jswiles/LoRaIO_3x12T/README.md

# LoRa Terminal I/O Board

LoRa (3) 12 Screw Terminal I/O Board

- 24LC32A 4K byte EEPROM 
    - Connected to I2C bus 1, can be used  for device configuration and data logging. 

- Buffered TTL RS-232 I/O   
    - UART1 – Debug port 
    - UART2 – User port 

- LTC4311 I2C Bus Accelerator 
    - Up to 1 meter length connections to I2C bus 2 at 400Khz.

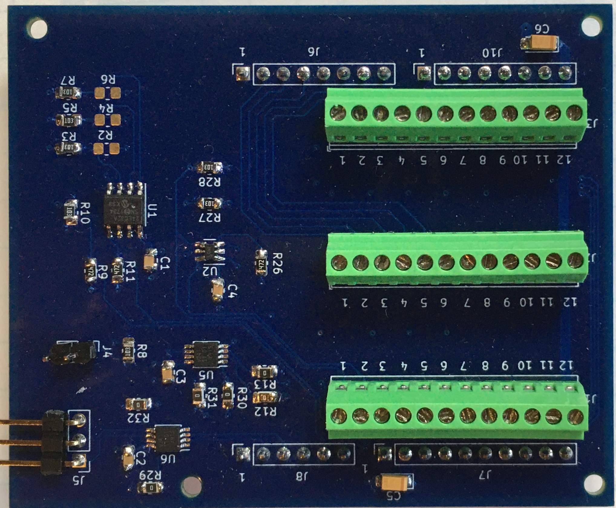
[picture p1: Photos/LoRaIO_3x12T_R1.JPG]
LoRaIO_3x12T_R1 Revision 1


Revision 1 

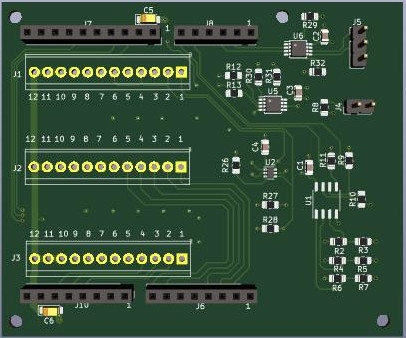
[picture p2: Photos/LoRaIO_3x12T_R13D.JPG]
LoRaIO_3x12T_R2 Revision 2


Revision 1 3D Model
