jswiles/LoRaIO_3x12T/Documents/LoRaIO_3x12T_SCH_R1.pdf

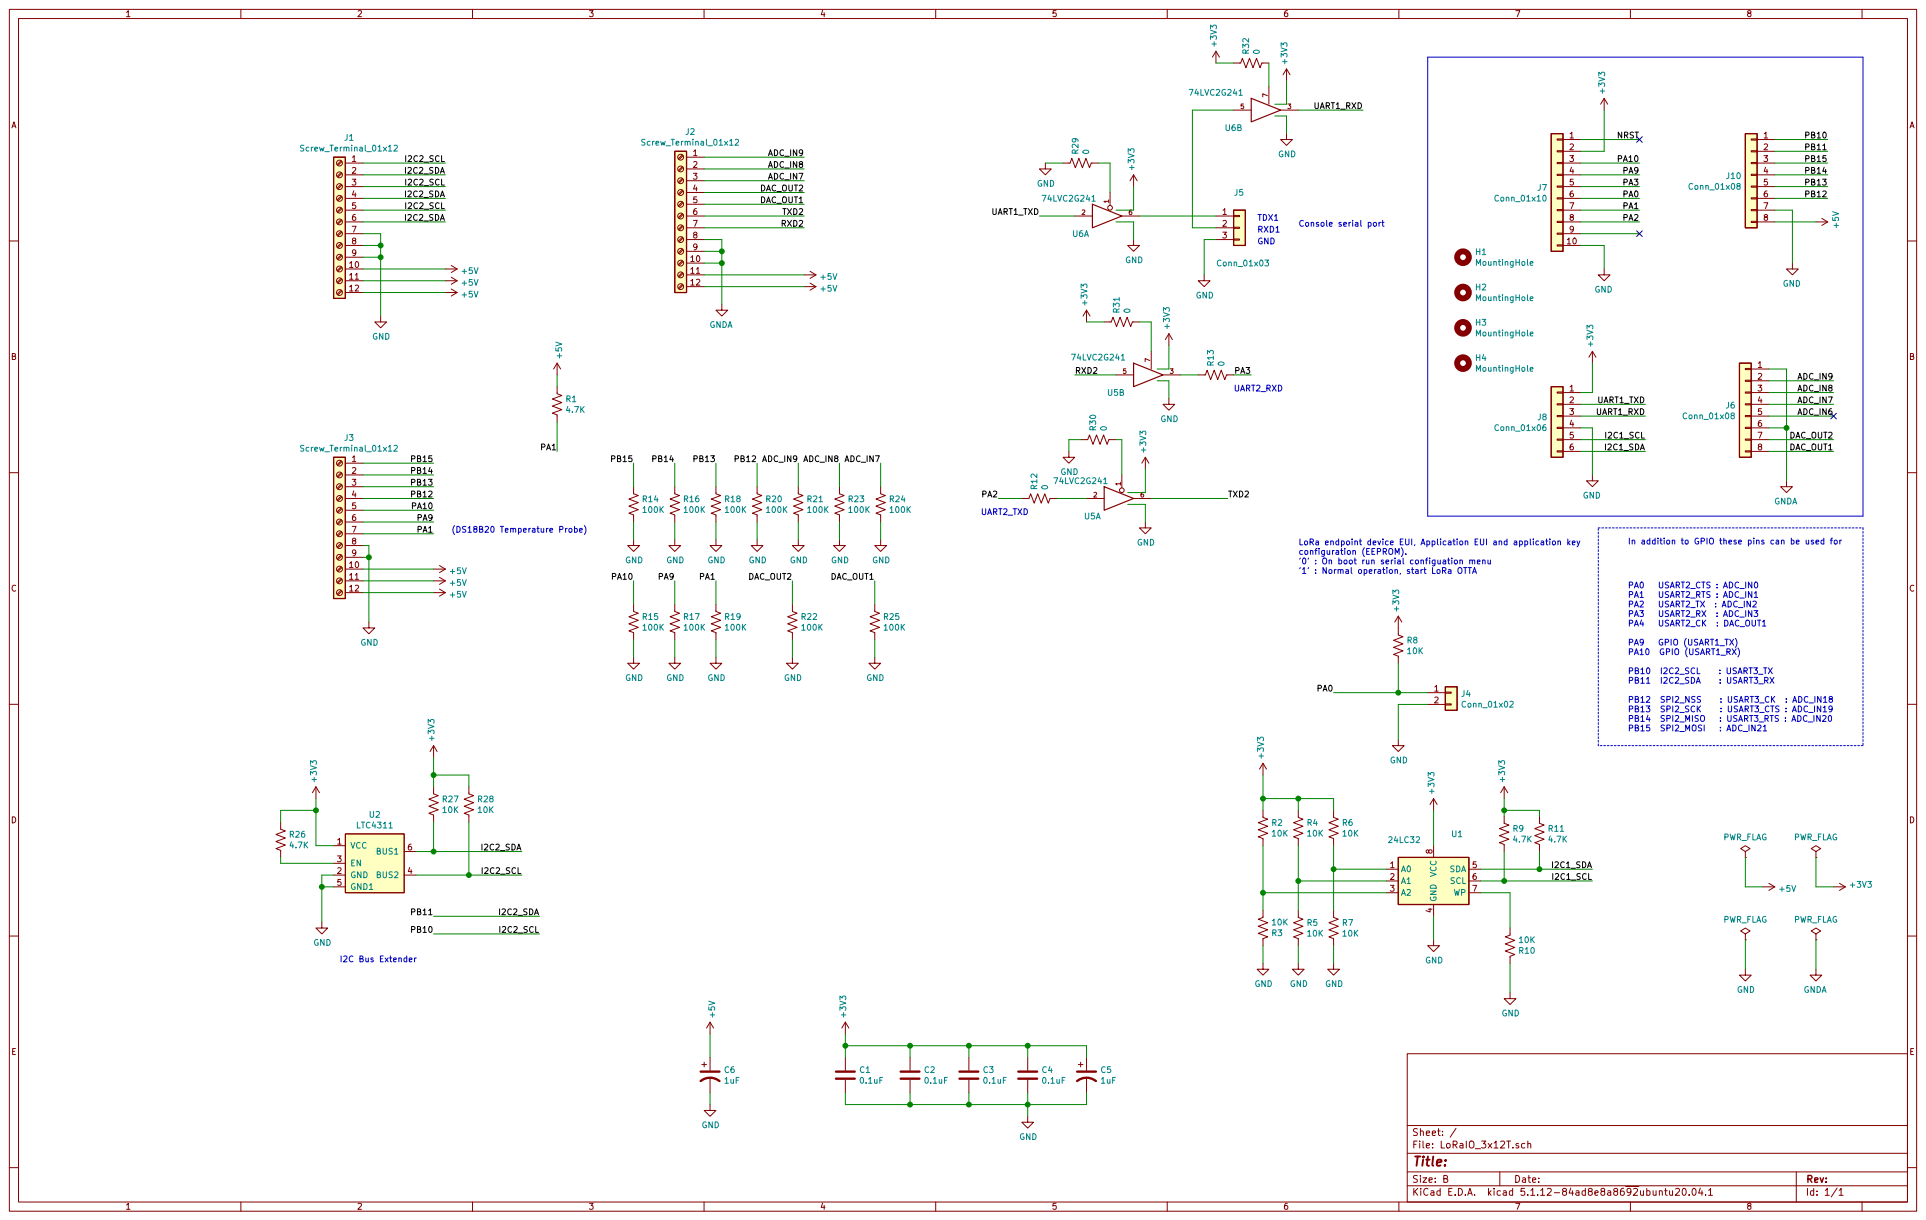
[picture p4: page 1]

In addition to GPIO these pins can be used for TDX1 UART2_RXD
RXD1
GND

'1' : Normal operation, start LoRa OTTA UART2_TXD

LoRa endpoint device EUI, Application EUI and application key
configuration (EEPROM).
'0' : On boot run serial configuation menu
