jswiles/LoRaIO_3x12T/Schematic/LoRaIO_3x12T.kicad_pcb

## KiCad design Schematic/LoRaIO_3x12T.kicad_pcb (2022-08-01)

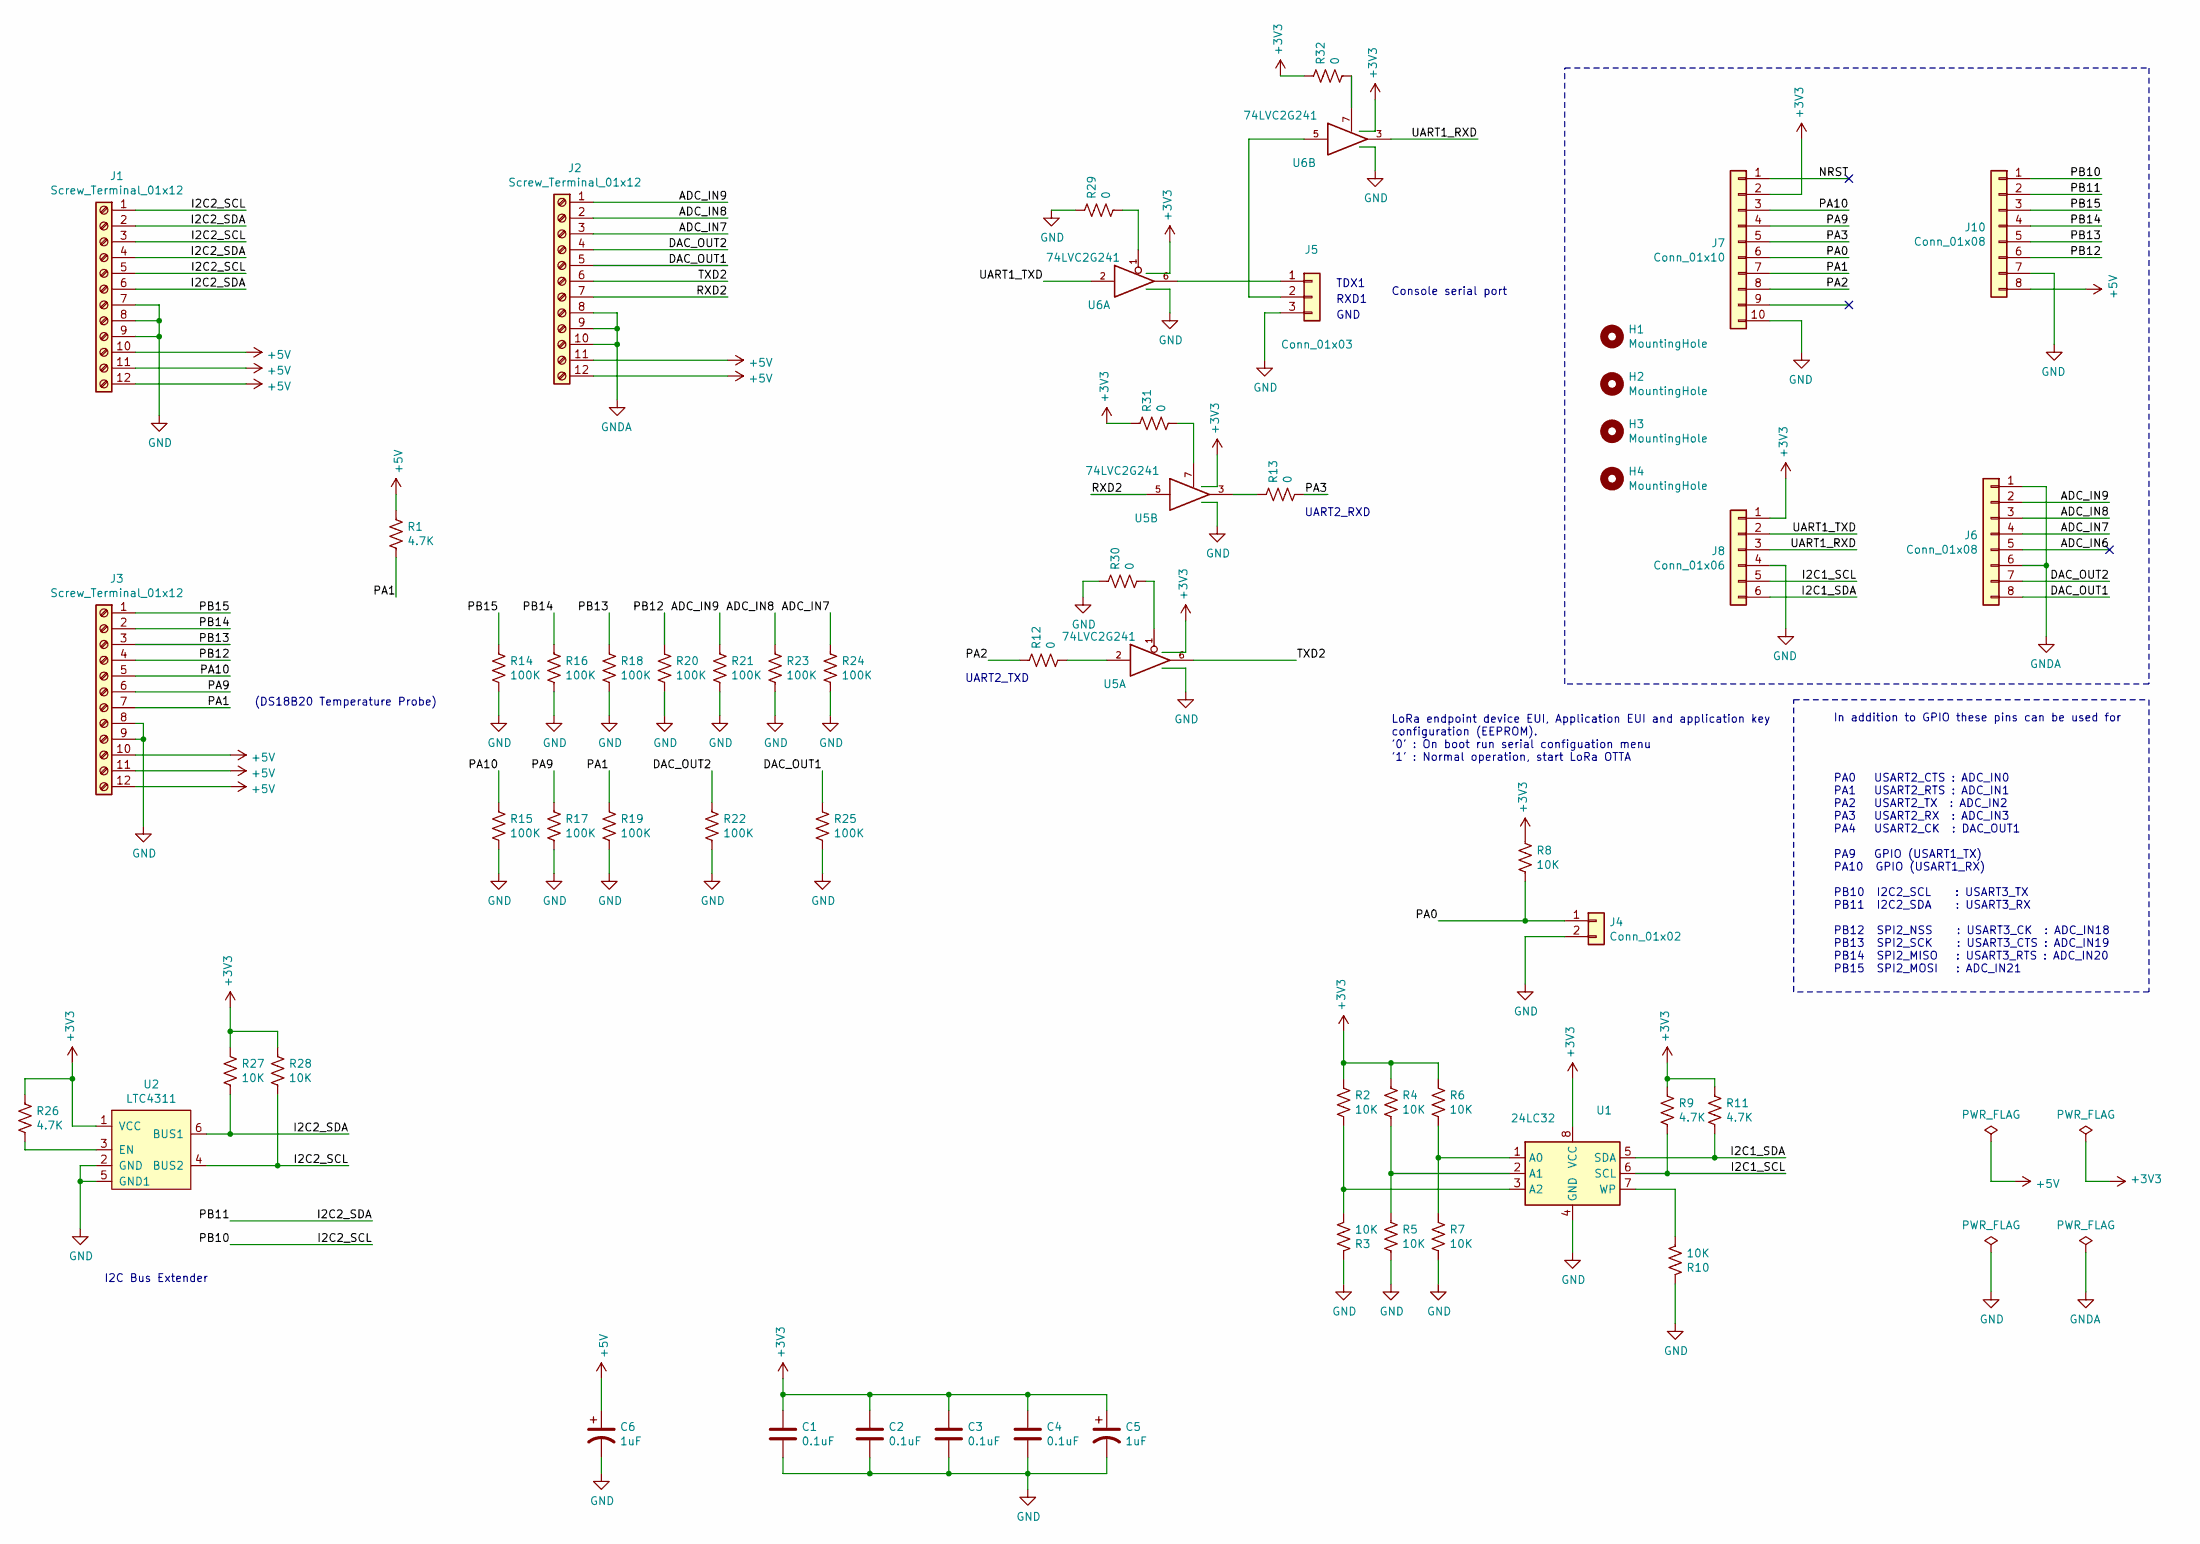
[picture p5: schematic LoRaIO_3x12T.sch]

Parts:
C1, C2, C3, C4: 0.1uF; C_0805_2012Metric; DigiKey 311-1140-1-ND
C5, C6: 1uF; CP_EIA-3216-18_Kemet-A_Pad1.58x1.35mm_HandSolder; DigiKey 399-3684-1-ND
H1, H2, H3, H4: MountingHole; MountingHole_2.5mm
J1, J2, J3: Screw_Terminal_01x12; TerminalBlock_TE_1-282834-2_1x12_P2.54mm_Horizontal
J4: Conn_01x02; PinHeader_1x02_P2.54mm_Vertical
J5: Conn_01x03; PinHeader_1x03_P2.54mm_Vertical
J6, J10: Conn_01x08; PinSocket_1x08_P2.54mm_Vertical; DigiKey S1011EC-40-ND
J7: Conn_01x10; PinSocket_1x10_P2.54mm_Vertical; DigiKey S1011EC-40-ND
J8: Conn_01x06; PinSocket_1x06_P2.54mm_Vertical; DigiKey S1011EC-40-ND
R1, R26: 4.7K; R_0805_2012Metric_Pad1.20x1.40mm_HandSolder; DigiKey 311-4.7KARCT-ND
R2, R3, R4, R5, R6, R7, R8, R10, R27, R28: 10K; R_0805_2012Metric_Pad1.20x1.40mm_HandSolder; DigiKey RMCF0805JT10K0CT-ND
R9, R11: 4.7K; R_0805_2012Metric_Pad1.20x1.40mm_HandSolder
R12, R13, R29, R30, R31, R32: 0; R_0805_2012Metric_Pad1.20x1.40mm_HandSolder; DigiKey RMCF0805ZT0R00CT-ND
R14, R15, R16, R17, R18, R19, R20, R21, R22, R23, R24, R25: 100K; R_0805_2012Metric_Pad1.20x1.40mm_HandSolder; DigiKey 311-100KARCT-ND
U1: 24LC32; SO-8_3.9x4.9mm_P1.27mm; DigiKey 24LC32AF-E/SN-ND
U2: LTC4311; sc70_6; DigiKey LTC4311CSC6#TRPBFCT-ND
U5: 74LVC2G241; TSSOP-8_3x3mm_P0.65mm; DigiKey 1727-7019-1-ND
U6: 74LVC2G241; TSSOP-8_3x3mm_P0.65mm

Connections:
+3V3: C1.1, C2.1, C3.1, C4.1, C5.1, J7.2, J8.1, R2.1, R4.1, R6.1, R8.1, R9.1, R11.1, R26.1, R27.1, R28.1, R31.1, R32.1, U1.8 (VCC), U2.1 (VCC), U5.8 (VCC), U6.8 (VCC)
+5V: C6.1, J1.10, J1.11, J1.12, J2.11, J2.12, J3.10, J3.11, J3.12, J10.8, R1.1
/ADC_IN7: J2.3, J6.4, R24.1
/ADC_IN8: J2.2, J6.3, R23.1
/ADC_IN9: J2.1, J6.2, R21.1
/DAC_OUT1: J2.5, J6.8, R25.1
/DAC_OUT2: J2.4, J6.7, R22.1
/I2C1_SCL: J8.5, R9.2, U1.6 (SCL)
/I2C1_SDA: J8.6, R11.2, U1.5 (SDA)
/I2C2_SCL: J1.1, J1.3, J1.5, J10.1, R28.2, U2.4 (BUS2)
/I2C2_SDA: J1.2, J1.4, J1.6, J10.2, R27.2, U2.6 (BUS1)
/PA0: J4.1, J7.6, R8.2
/PA1: J3.7, J7.7, R1.2, R19.1
/PA2: J7.8, R12.1
/PA3: J7.5, R13.2
/PA9: J3.6, J7.4, R17.1
/PA10: J3.5, J7.3, R15.1
/PB12: J3.4, J10.6, R20.1
/PB13: J3.3, J10.5, R18.1
/PB14: J3.2, J10.4, R16.1
/PB15: J3.1, J10.3, R14.1
/RXD2: J2.7, U5.5
/TXD2: J2.6, U5.6
/UART1_RXD: J8.3, U6.3
/UART1_TXD: J8.2, U6.2
GND: C1.2, C2.2, C3.2, C4.2, C5.2, C6.2, J1.7, J1.8, J1.9, J3.8, J3.9, J4.2, J5.3, J7.10, J8.4, J10.7, R3.1, R5.2, R7.2, R10.1, R14.2, R15.2, R16.2, R17.2, R18.2, R19.2, R20.2, R21.2, R22.2, R23.2, R24.2, R25.2, R29.1, R30.1, U1.4 (GND), U2.2 (GND), U2.5 (GND1), U5.4 (GND), U6.4 (GND)
GNDA: J2.8, J2.9, J2.10, J6.1, J6.6
unnamed: J5.1, U6.6
unnamed: J5.2, U6.5
unnamed: R2.2, R3.2, U1.3 (A2)
unnamed: R4.2, R5.1, U1.2 (A1)
unnamed: R6.2, R7.1, U1.1 (A0)
unnamed: R10.2, U1.7 (WP)
unnamed: R12.2, U5.2
unnamed: R13.1, U5.3
unnamed: R26.2, U2.3 (EN)
unnamed: R29.2, U6.1
unnamed: R30.2, U5.1
unnamed: R31.2, U5.7
unnamed: R32.2, U6.7

Notes on the sheet:
In addition to GPIO these pins can be used for
LoRa endpoint device EUI, Application EUI and application key configuration (EEPROM). '0' : On boot run serial configuation menu '1' : Normal operation, start LoRa OTTA
PA0 USART2_CTS : ADC_IN0 PA1 USART2_RTS : ADC_IN1 PA2 USART2_TX : ADC_IN2 PA3 USART2_RX : ADC_IN3 PA4 USART2_CK : DAC_OUT1 PA9 GPIO (USART1_TX) PA10 GPIO (USART1_RX) PB10 I2C2_SCL : USART3_TX PB11 I2C2_SDA : USART3_RX PB12 SPI2_NSS : USART3_CK : ADC_IN18 PB13 SPI2_SCK : USART3_CTS : ADC_IN19 PB14 S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
(DS18B20 Temperature Probe)
TDX1
RXD1
GND
UART2_TXD
UART2_RXD
Console serial port
I2C Bus Extender

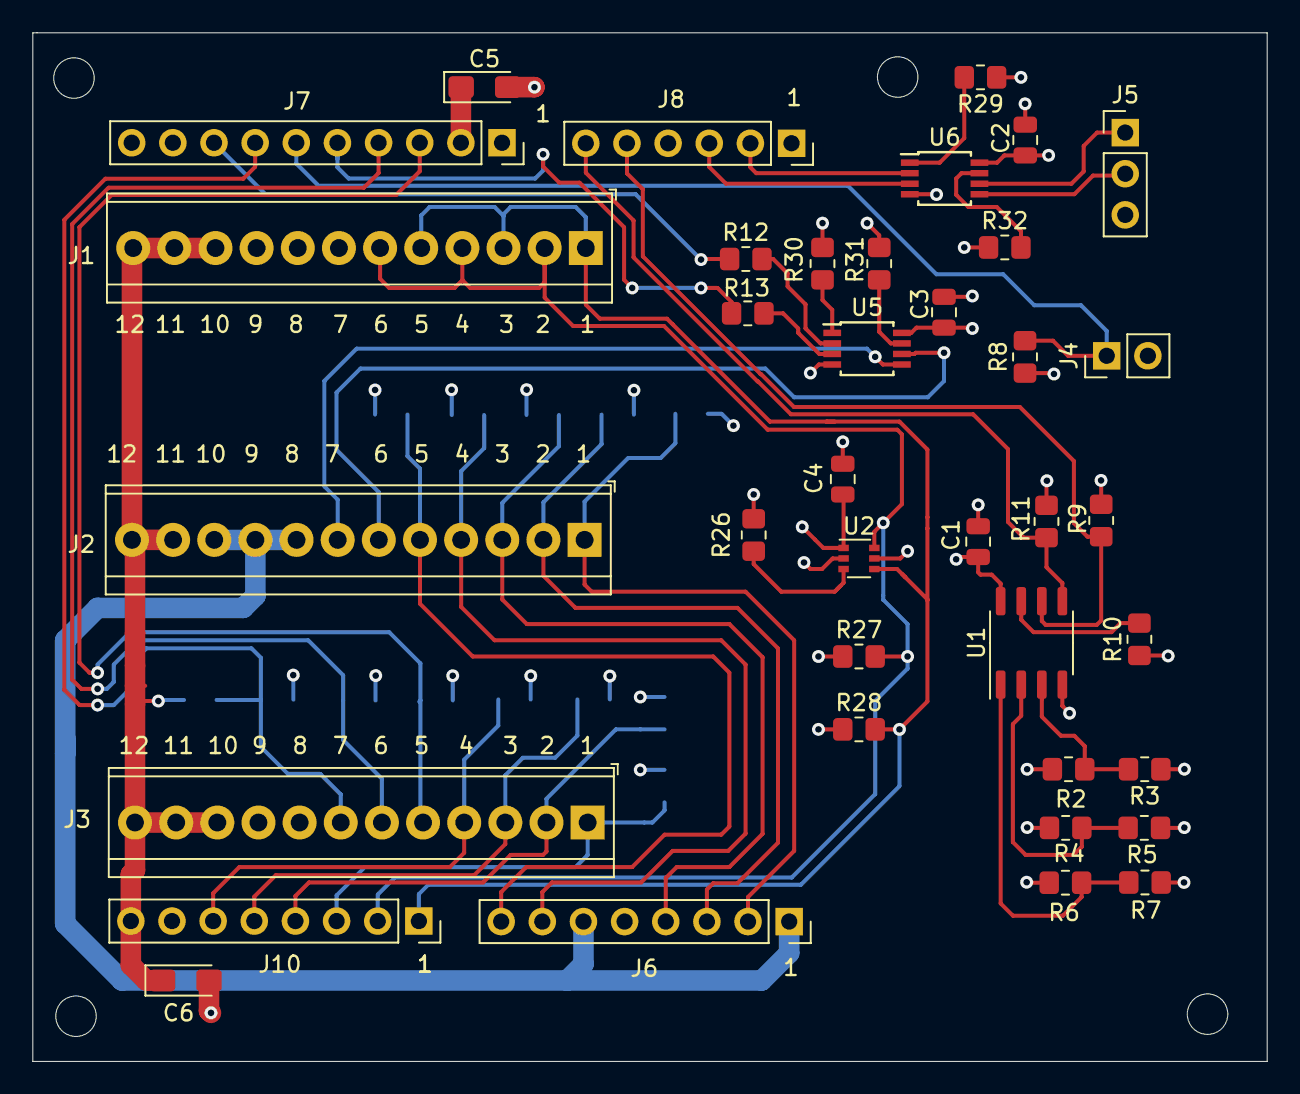
[picture p6: board LoRaIO_3x12T.kicad_pcb from above]

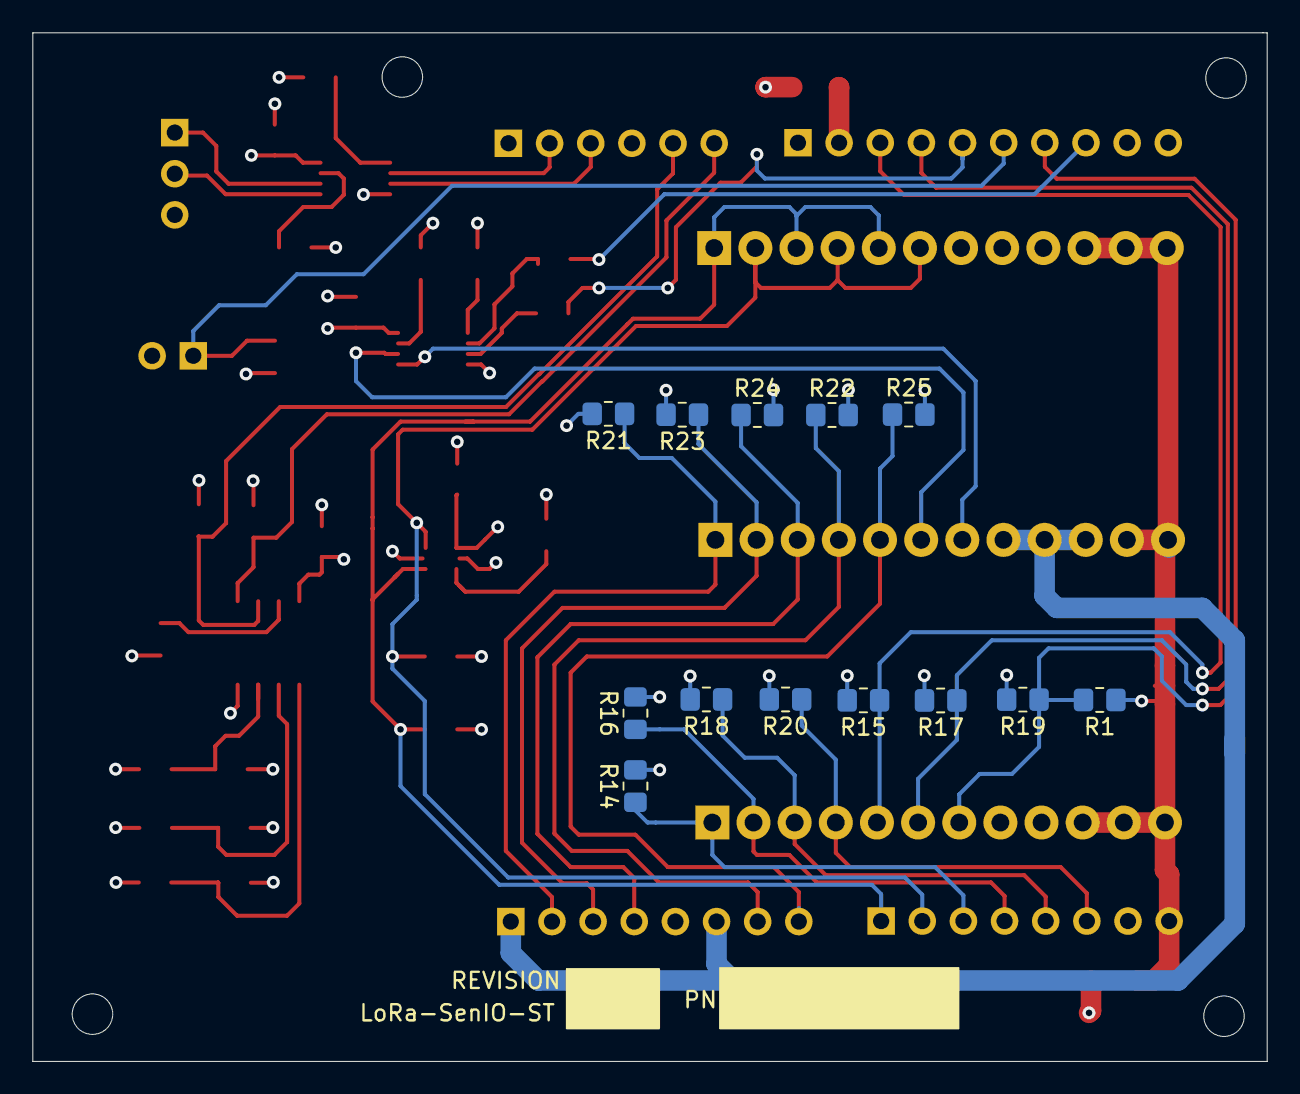
[picture p7: board LoRaIO_3x12T.kicad_pcb from below]

Board: 4 copper layers, 76.2 x 63.5 mm, 55 parts (13 on the bottom side), 40 nets.
