jswiles/LoRaIO_3x12T/(commit log)

2022-08-01 Added BOM directory
    [LoRaIO_3x12T.csv]
2022-08-01 Added Schematic directory
    [LoRaIO_3x12T.kicad_pcb, LoRaIO_3x12T.sch]
